FrWA14/KiCad8_ESP32S3_DevModule_wroom-1_DevelopementBoard/ESP32_S3_devkit_test/ESP32.jpg

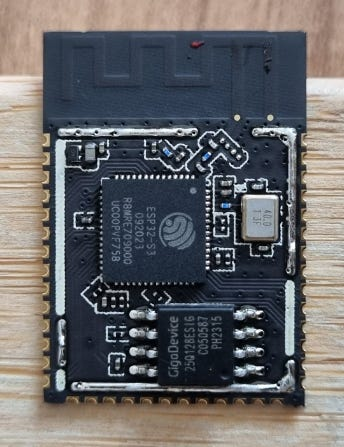
ESP32_S3_devkit_test/ESP32.jpg
