FrWA14/KiCad8_ESP32S3_DevModule_wroom-1_DevelopementBoard/README.md

Contient tout le projet KiCad afin de faire une carte de développement ESP32 :

-Schématique
-PCB
-BOM et référence JLCPCB

/!\ Il faudra faire la rotation de certains composants lors de la production chez JLCPCB.
