FrWA14/KiCad8_ESP32S3_DevModule_wroom-1_DevelopementBoard/ESP32_S3_devkit_test/Schematic-for-Using-USB-C-Connectors-with-Full-Pinout.png

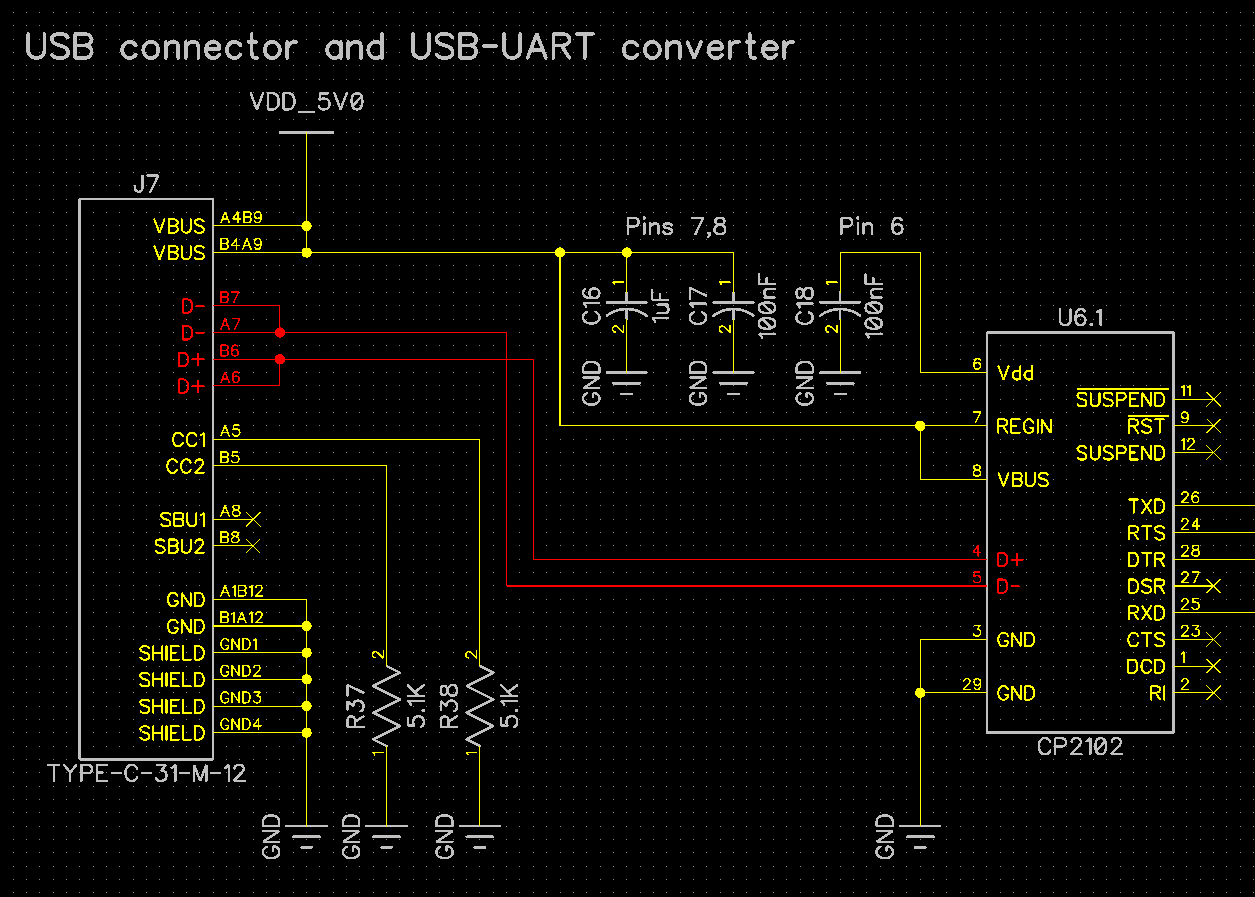
ESP32_S3_devkit_test/Schematic-for-Using-USB-C-Connectors-with-Full-Pinout.png
