FrWA14/KiCad8_ESP32S3_DevModule_wroom-1_DevelopementBoard/ESP32_S3_devkit_test/ESP32_S3_devkit_test.pdf

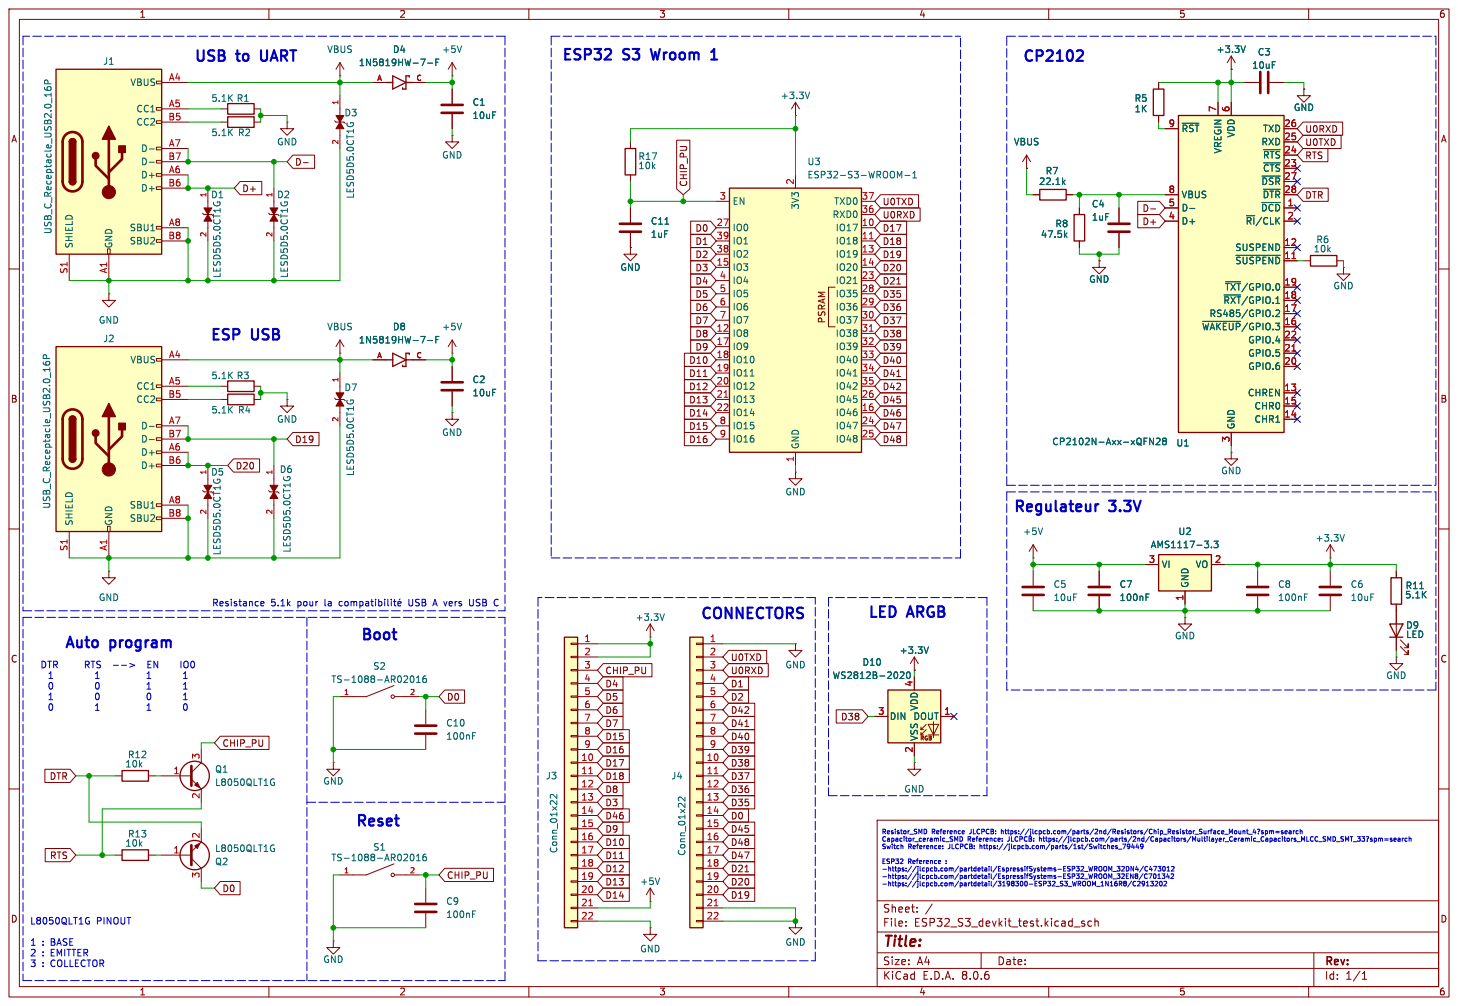
[picture p3: page 1]

1 VO 2 VI 3 CP2102N-Axx-xQFN28 U1 ~{DCD}1 ~{SUSPEND}11 SUSPEND 12 CHREN 13 CHR1 14 CHR0 15 ~{WAKEUP}/GPIO.316 RS485/GPIO.2 17 ~{RXT}/GPIO.118 ~{TXT}/GPIO.019 ~{RI}/CLK2 GPIO.6 20 GPIO.5 21 GPIO.4 22 ~{CTS} 23 ~{RTS} 24 RXD 25 TXD 26 ~{DSR} 27 ~{DTR} 28 GND

-https://jlcpcb.com/partdetail/EspressifSystems-ESP32_WROOM_32EN8/C701342

-https://jlcpcb.com/partdetail/3198300-ESP32_S3_WROOM_1N16R8/C2913202 L8050QLT1G PINOUT

Id: 1/1 Title: File: ESP32_S3_devkit_test.kicad_sch Sheet: /
