FrWA14/KiCad8_ESP32S3_DevModule_wroom-1_DevelopementBoard/ESP32_S3_devkit_test/SCH_ESP32-S3-DevKitC-1_V1.1.pdf

# System Block:

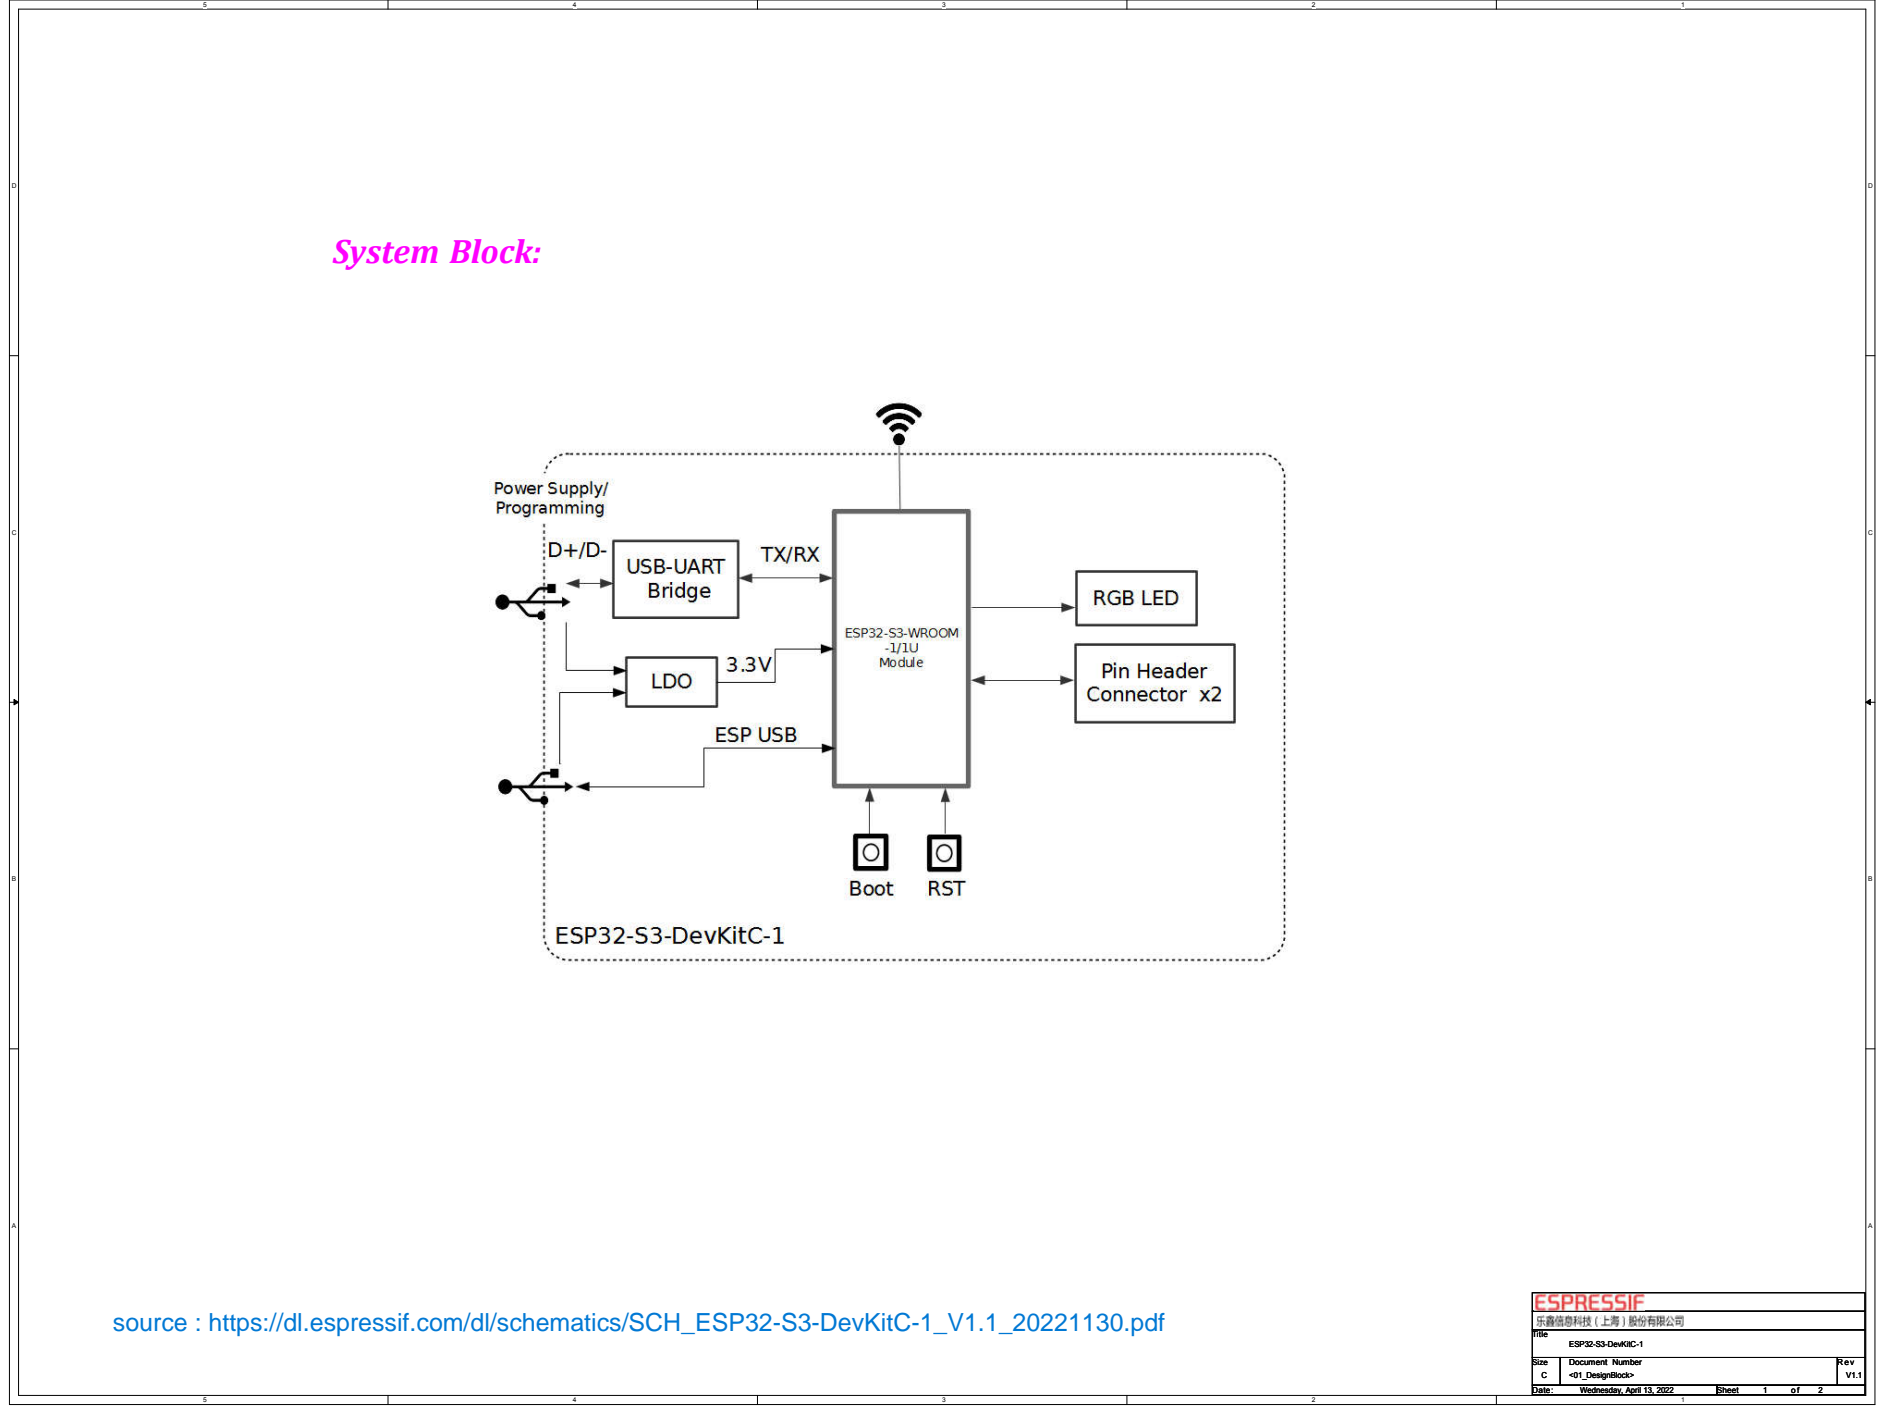
[picture p4: page 1]
Title; Size; Document Number; Date:; Sheet; <01_DesignBlock>; ESP32-S3-DevKitC-1; Wednesday, April 13, 2022

# USB to UART:

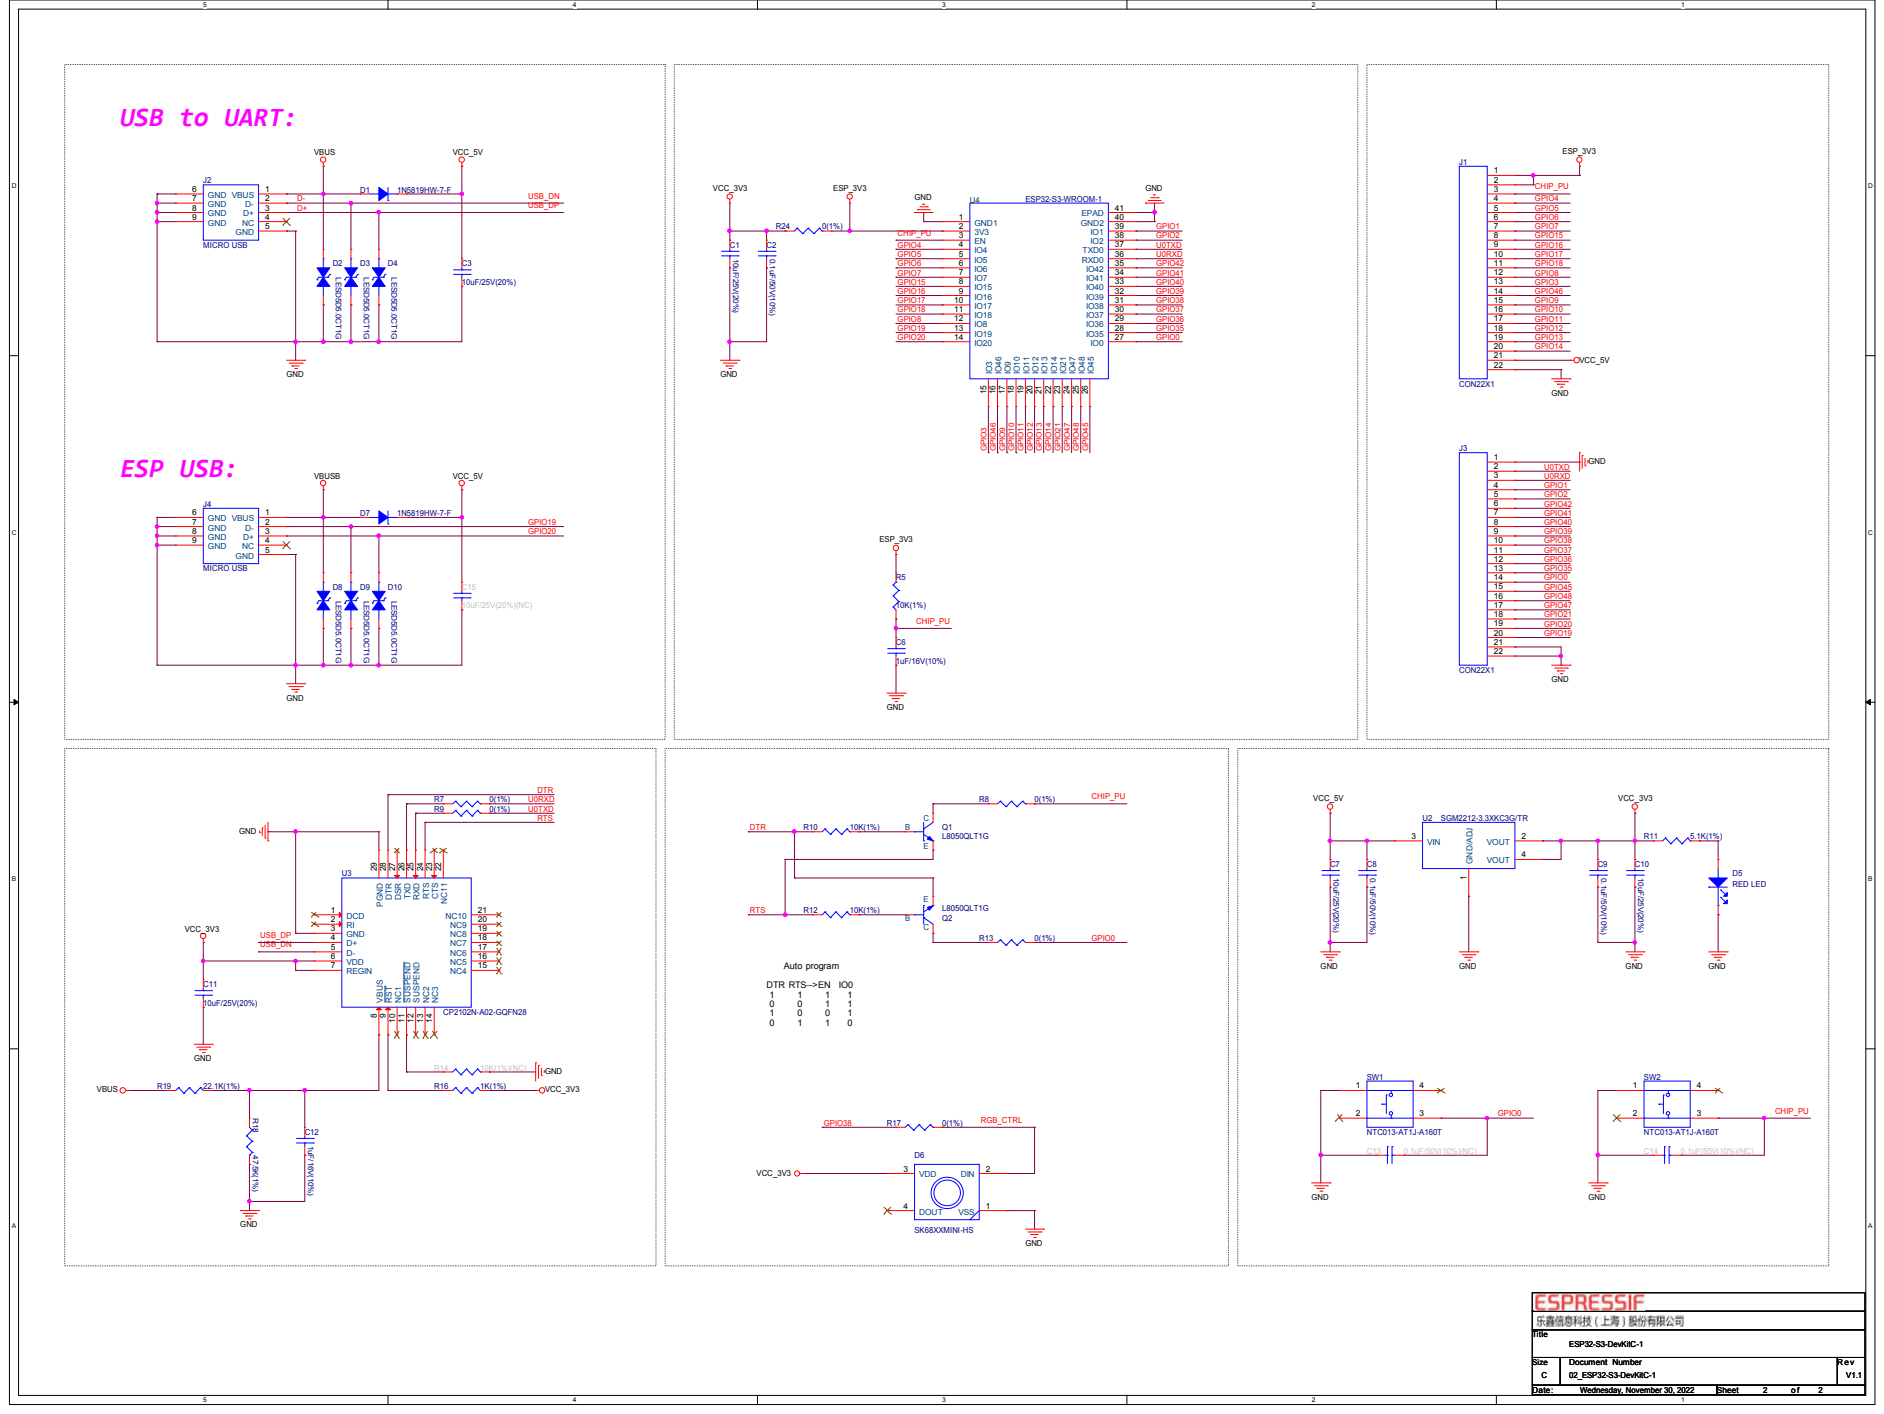
[picture p5: page 2]
