FrWA14/KiCad8_ESP32S3_DevModule_wroom-1_DevelopementBoard/ESP32_S3_devkit_test/ESP32_S3_devkit_test.kicad_pcb

## KiCad design ESP32_S3_devkit_test/ESP32_S3_devkit_test.kicad_pcb (2025-03-26)

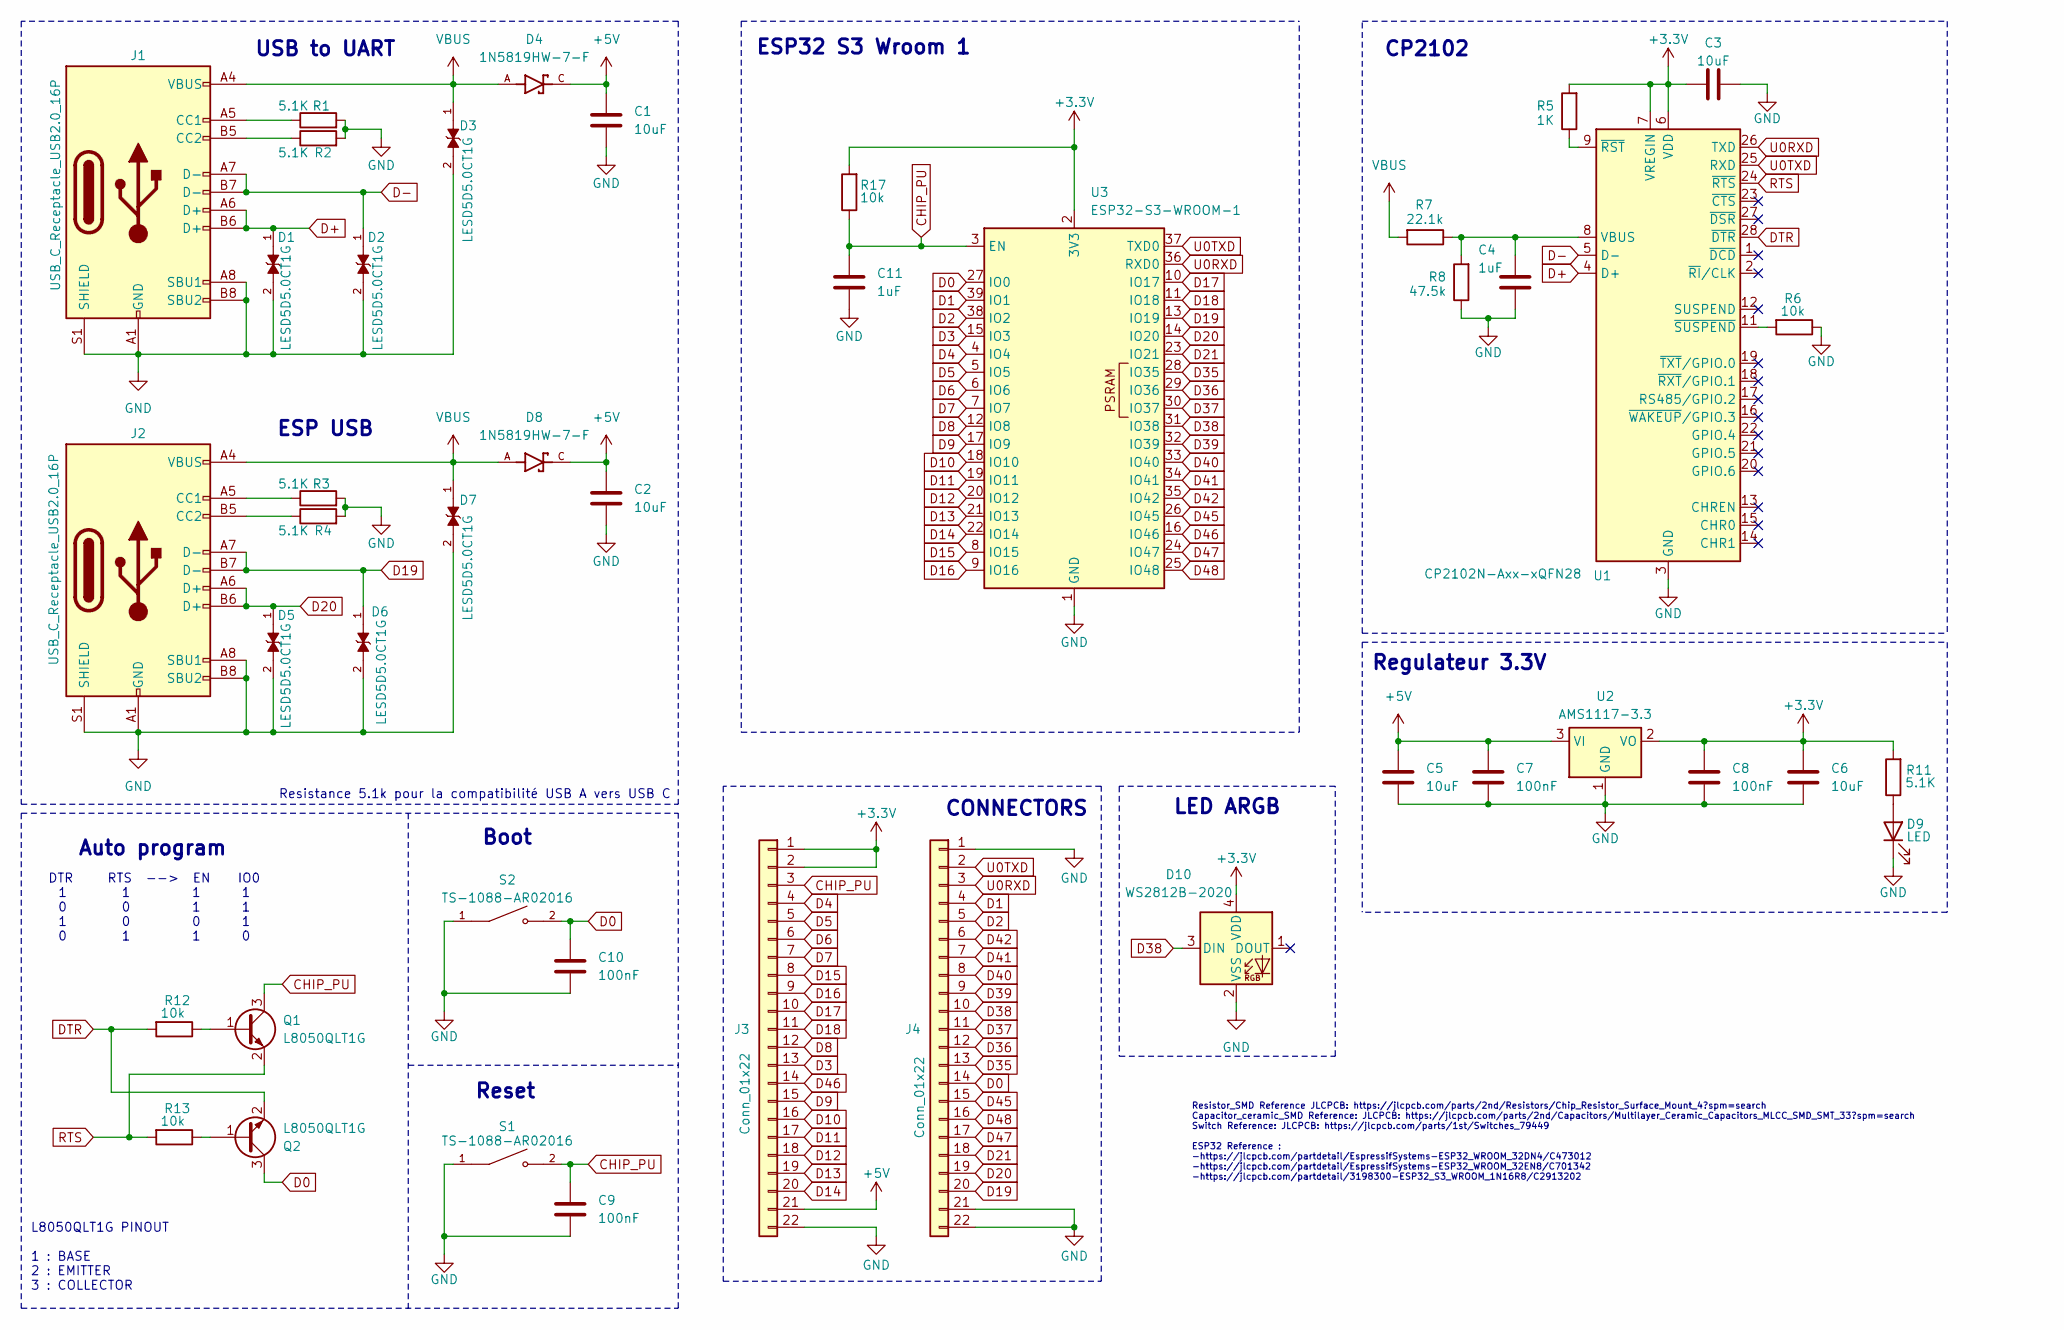
[picture p6: schematic ESP32_S3_devkit_test.kicad_sch]

Parts:
C1, C2, C3, C5, C6: 10uF; C_0603_1608Metric; JLCPCB Part # C1691
C4, C11: 1uF; C_0603_1608Metric; JLCPCB Part # C15849
C7, C8, C9, C10: 100nF; C_0603_1608Metric; JLCPCB Part # C14663
D1, D2, D3, D5, D6, D7: LESD5D5.0CT1G; D_SOD-523_LESD5D5.0CT1G; PARTREV O; JLCPCB Part # C383211
D4, D8: 1N5819HW-7-F; D_SOD-123_1N5819HW-7-F; PARTREV 18-2; JLCPCB Part # C82544
D9: LED; LED_0603_1608Metric; JLCPCB Part # C965799
D10: WS2812B-2020; LED_WS2812B-2020_PLCC4_2.0x2.0mm; JLCPCB Part # C965555
J1, J2: USB_C_Receptacle_USB2.0_16P; USB_C_Receptacle_HCTL_HC-TYPE-C-16P-01A; JLCPCB Part # C393939
J3, J4: Conn_01x22; PinHeader_1x22_P2.54mm_Vertical; JLCPCB Part # C20610289
Q1, Q2: L8050QLT1G; SOT-23; JLCPCB Part # C49581
R1, R2, R3, R4, R11: 5.1K; R_0603_1608Metric; JLCPCB Part # C23186
R5: 1K; R_0603_1608Metric; JLCPCB Part # C21190
R6, R12, R13, R17: 10k; R_0603_1608Metric; JLCPCB Part # C25804
R7: 22.1k; R_0603_1608Metric; JLCPCB Part # C25961
R8: 47.5k; R_0603_1608Metric; JLCPCB Part # C23061
S1, S2: TS-1088-AR02016; SW_TS-1088-AR02016; PARTREV N/A; JLCPCB Part # C720477
U1: CP2102N-Axx-xQFN28; QFN-28-1EP_5x5mm_P0.5mm_EP3.35x3.35mm; JLCPCB Part # C964632
U2: AMS1117-3.3; SOT-223-3_TabPin2; JLCPCB Part # C6186
U3: ESP32-S3-WROOM-1; JLCPCB Part # C2913202

Connections:
+3.3V: C3.1, C6.1, C8.1, D10.4 (VDD), J3.1, J3.2, R5.2, R11.2, R17.2, U1.6 (VDD), U1.7 (VREGIN), U2.2 (VO), U3.2 (3V3)
+5V: C1.1, C2.1, C5.1, C7.1, D4.C, D8.C, J3.21, U2.3 (VI)
CHIP_PU: C9.1, C11.1, J3.3, Q1.3 (C), R17.1, S1.2, U3.3 (EN)
D0: C10.1, J4.14, Q2.3 (C), S2.2, U3.27 (IO0)
D1: J4.4, U3.39 (IO1)
D2: J4.5, U3.38 (IO2)
D3: J3.13, U3.15 (IO3)
D4: J3.4, U3.4 (IO4)
D5: J3.5, U3.5 (IO5)
D6: J3.6, U3.6 (IO6)
D7: J3.7, U3.7 (IO7)
D8: J3.12, U3.12 (IO8)
D9: J3.15, U3.17 (IO9)
D10: J3.16, U3.18 (IO10)
D11: J3.17, U3.19 (IO11)
D12: J3.18, U3.20 (IO12)
D13: J3.19, U3.21 (IO13)
D14: J3.20, U3.22 (IO14)
D15: J3.8, U3.8 (IO15)
D16: J3.9, U3.9 (IO16)
D17: J3.10, U3.10 (IO17)
D18: J3.11, U3.11 (IO18)
D19: D6.1, J2.A7 (D-), J2.B7 (D-), J4.20, U3.13 (IO19)
D20: D5.1, J2.A6 (D+), J2.B6 (D+), J4.19, U3.14 (IO20)
D21: J4.18, U3.23 (IO21)
D35: J4.13, U3.28 (IO35)
D36: J4.12, U3.29 (IO36)
D37: J4.11, U3.30 (IO37)
D38: D10.3 (DIN), J4.10, U3.31 (IO38)
D39: J4.9, U3.32 (IO39)
D40: J4.8, U3.33 (IO40)
D41: J4.7, U3.34 (IO41)
D42: J4.6, U3.35 (IO42)
D45: J4.15, U3.26 (IO45)
D46: J3.14, U3.16 (IO46)
D47: J4.17, U3.24 (IO47)
D48: J4.16, U3.25 (IO48)
D+: D1.1, J1.A6 (D+), J1.B6 (D+), U1.4 (D+)
D-: D2.1, J1.A7 (D-), J1.B7 (D-), U1.5 (D-)
DTR: Q2.2 (E), R12.2, U1.28 (~DTR)
GND: C1.2, C2.2, C3.2, C4.2, C5.2, C6.2, C7.2, C8.2, C9.2, C10.2, C11.2, D1.2, D2.2, D3.2, D5.2, D6.2, D7.2, D9.1 (K), D10.2 (VSS), J1.A1 (GND), J1.A8 (SBU1), J1.A12 (GND), J1.B1 (GND), J1.B8 (SBU2), J1.B12 (GND), J1.S1 (SHIELD), J2.A1 (GND), J2.A8 (SBU1), J2.A12 (GND), J2.B1 (GND), J2.B8 (SBU2), J2.B12 (GND), J2.S1 (SHIELD), J3.22, J4.1, J4.21, J4.22, R1.2, R2.2, R3.2, R4.2, R6.1, R8.1, S1.1, S2.1, U1.3 (GND), U1.29 (GND), U2.1 (GND), U3.1 (GND), U3.40 (GND), U3.41 (GND)
unnamed: D9.2 (A), R11.1
unnamed: J1.A5 (CC1), R1.1
unnamed: J1.B5 (CC2), R2.1
unnamed: J2.A5 (CC1), R3.1
unnamed: J2.B5 (CC2), R4.1
unnamed: Q1.1 (B), R12.1
unnamed: Q2.1 (B), R13.1
unnamed: C4.1, R7.1, R8.2, U1.8 (VBUS)
unnamed: R5.1, U1.9 (~RST)
unnamed: R6.2, U1.11 (~SUSPEND)
RTS: Q1.2 (E), R13.2, U1.24 (~RTS)
U0RXD: J4.3, U1.26 (TXD), U3.36 (RXD0)
U0TXD: J4.2, U1.25 (RXD), U3.37 (TXD0)
VBUS: D3.1, D4.A, D7.1, D8.A, J1.A4 (VBUS), J1.A9 (VBUS), J1.B4 (VBUS), J1.B9 (VBUS), J2.A4 (VBUS), J2.A9 (VBUS), J2.B4 (VBUS), J2.B9 (VBUS), R7.2

Notes on the sheet:
LED ARGB
Resistor_SMD Reference JLCPCB: https://jlcpcb.com/parts/2nd/Resistors/Chip_Resistor_Surface_Mount_4?spm=search Capacitor_ceramic_SMD Reference: JLCPCB: https://jlcpcb.com/parts/2nd/Capacitors/Multilayer_Ceramic_Capacitors_MLCC_SMD_SMT_33?spm=search Switch Reference: JLCPCB: https://jlcpcb.com/parts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
ESP USB
Reset
Resistance 5.1k pour la compatibilité USB A vers USB C
L8050QLT1G PINOUT 1 : BASE 2 : EMITTER 3 : COLLECTOR
CONNECTORS
DTR RTS --> EN IO0 1 1 1 1 0 0 1 1 1 0 0 1 0 1 1 0
USB to UART
Boot
Regulateur 3.3V
Auto program
CP2102
ESP32 S3 Wroom 1

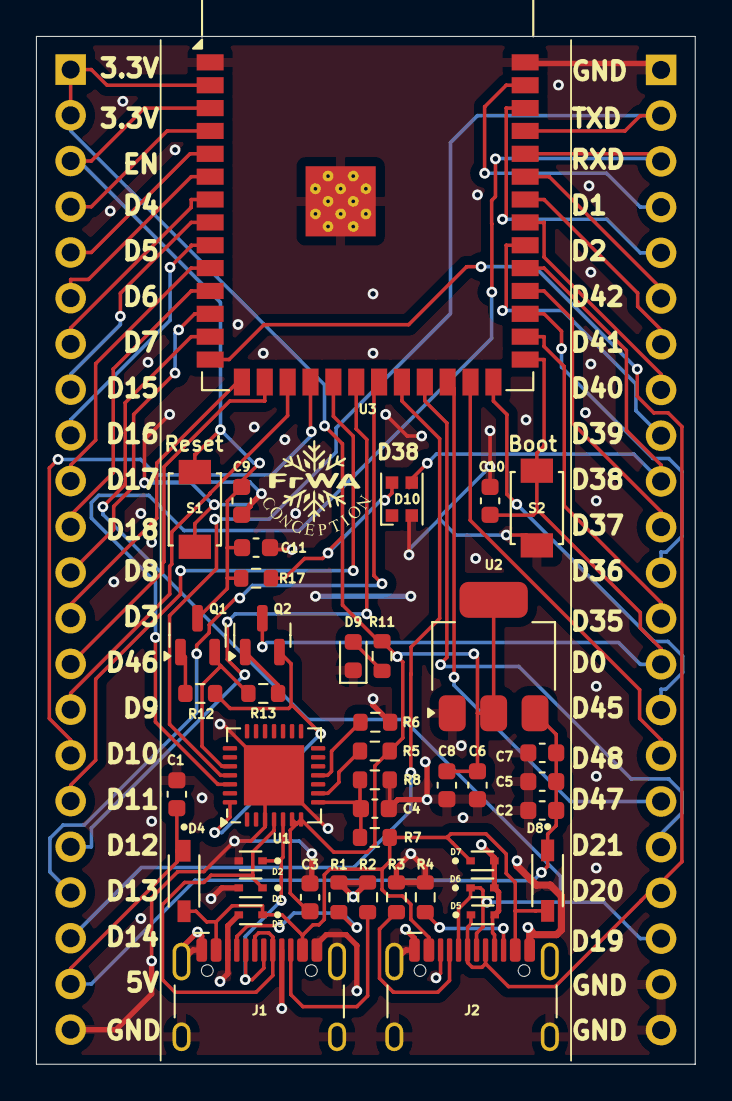
[picture p7: board ESP32_S3_devkit_test.kicad_pcb from above]

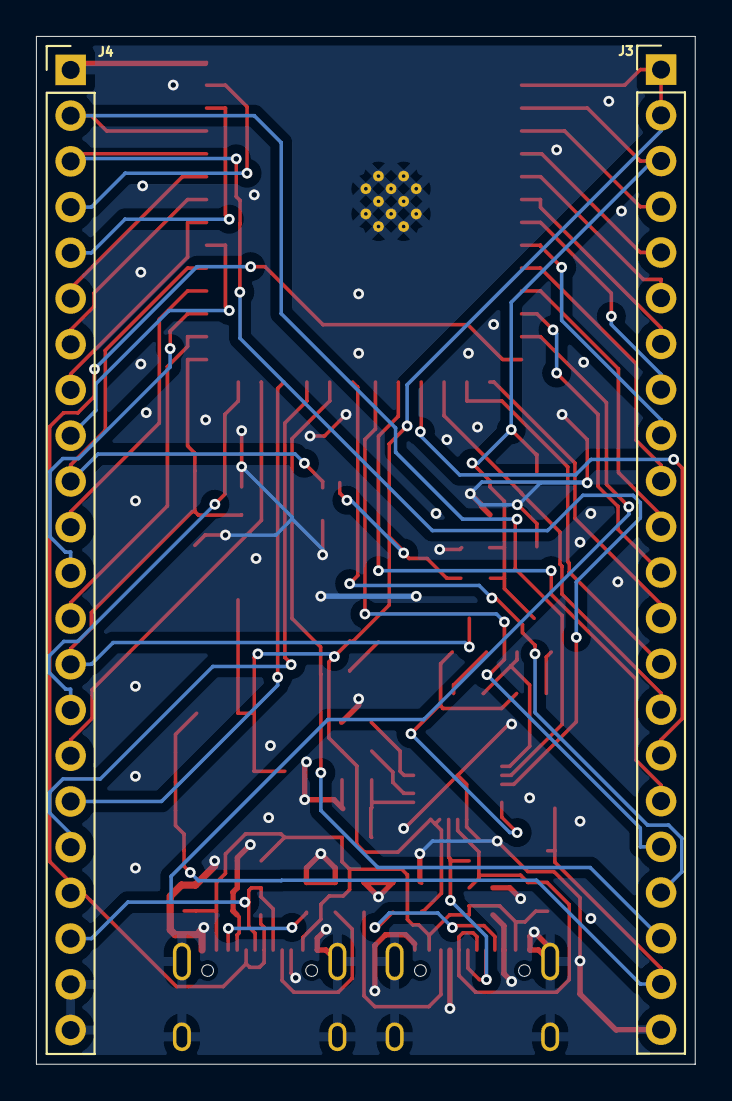
[picture p8: board ESP32_S3_devkit_test.kicad_pcb from below]

Board: 2 copper layers, 36.6 x 57.1 mm, 44 parts (2 on the bottom side), 55 nets.
